TamisiRaduNicolae/audioLF_amp_pcb/pics/crossover_temp2.jpg

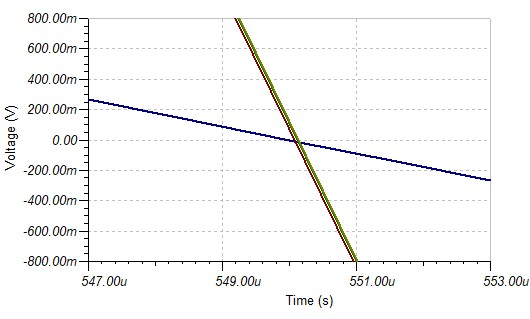
pics/crossover_temp2.jpg
