TamisiRaduNicolae/audioLF_amp_pcb/pics/crossover_temp.jpg

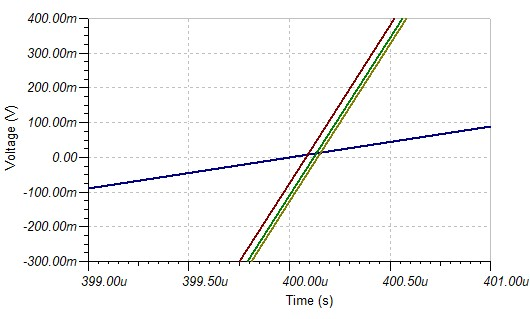
pics/crossover_temp.jpg
