TamisiRaduNicolae/audioLF_amp_pcb/pics/phase_margin.jpg

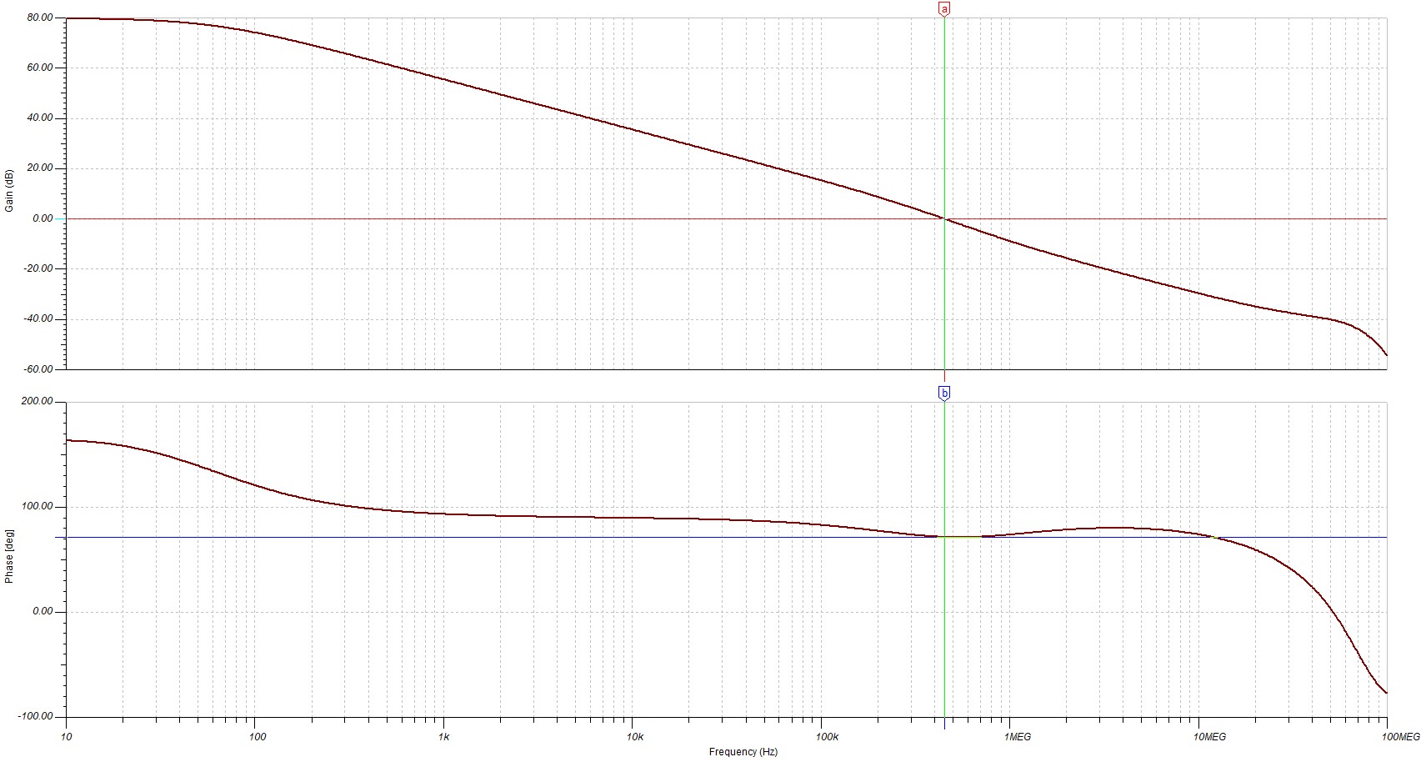
pics/phase_margin.jpg
