TamisiRaduNicolae/audioLF_amp_pcb/pics/rezerva_de_faza_71.66.png

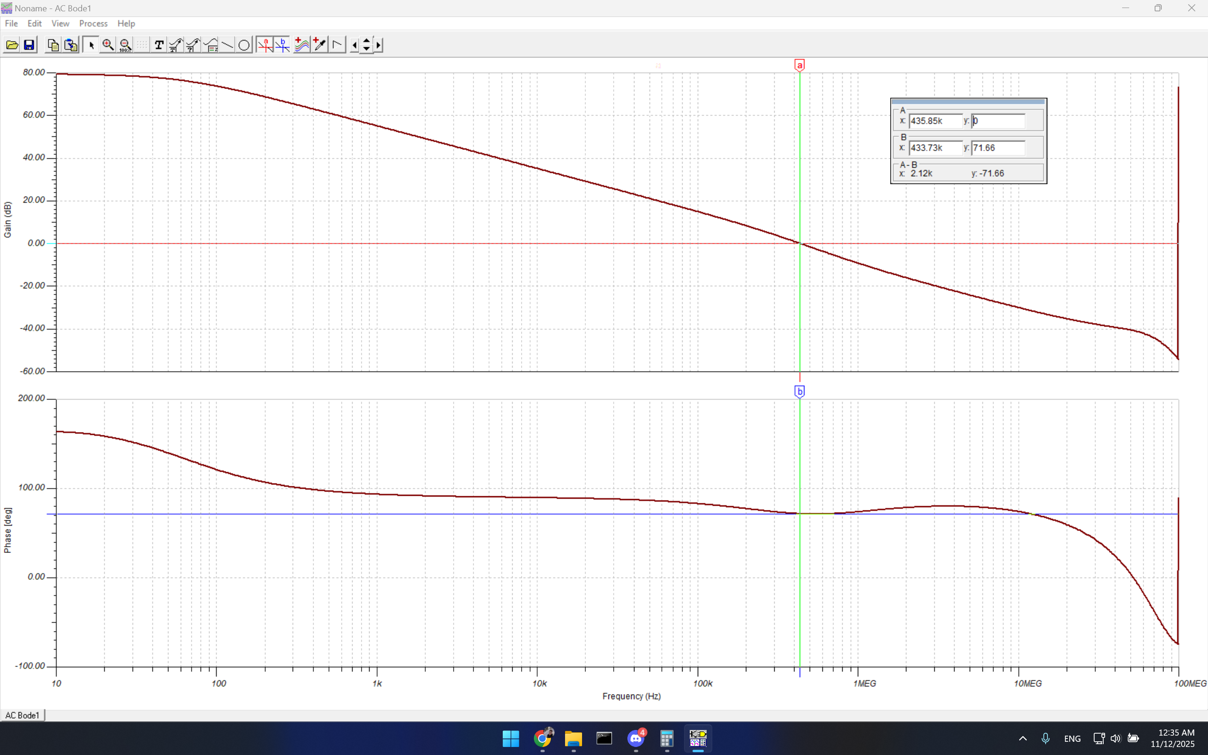
pics/rezerva_de_faza_71.66.png
