TamisiRaduNicolae/audioLF_amp_pcb/pics/Screenshot 2025-10-29 121659.png

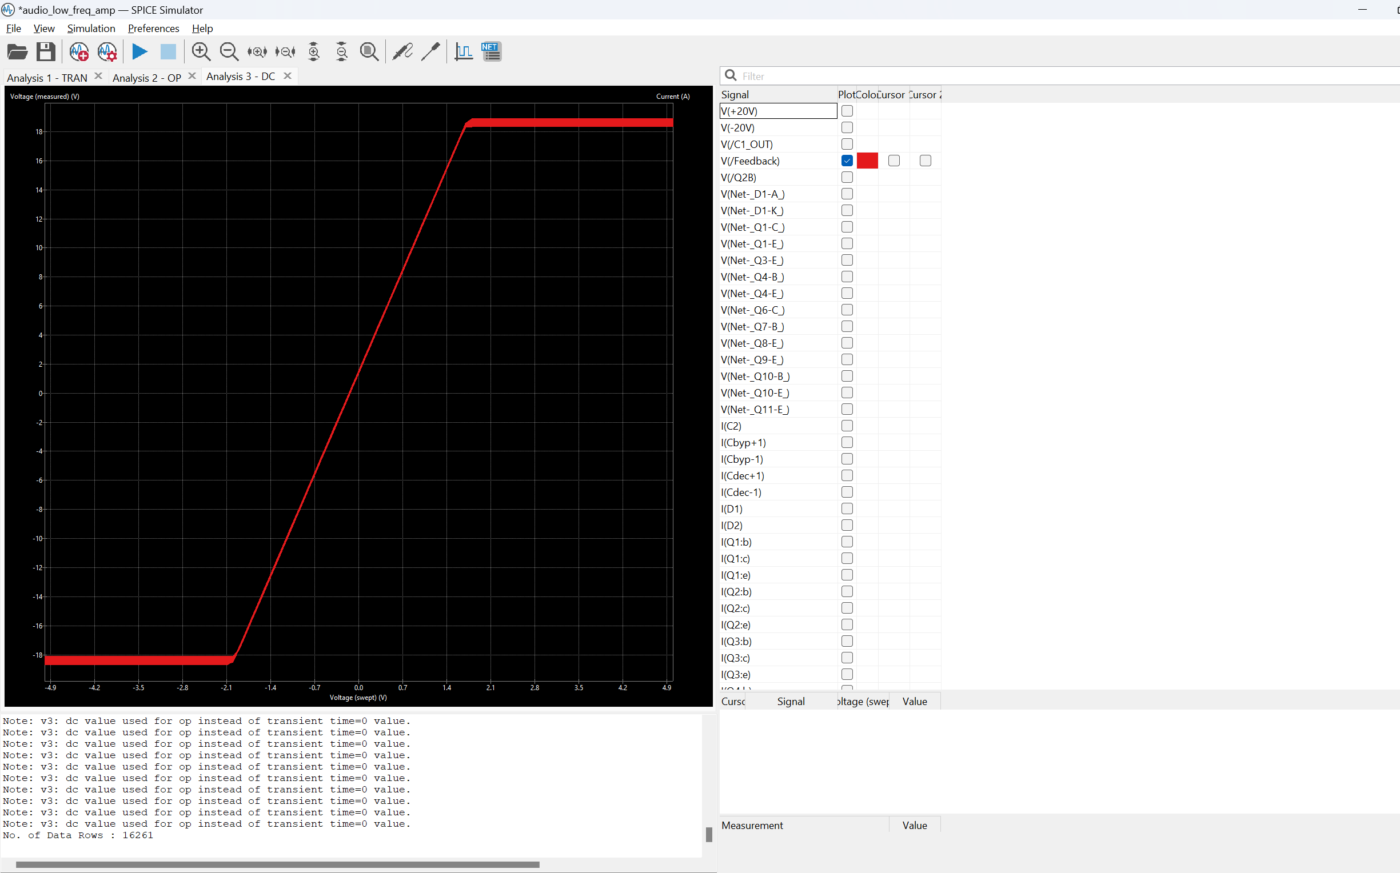
pics/Screenshot 2025-10-29 121659.png
