TamisiRaduNicolae/audioLF_amp_pcb/pics/Screenshot 2025-11-10 224111.png

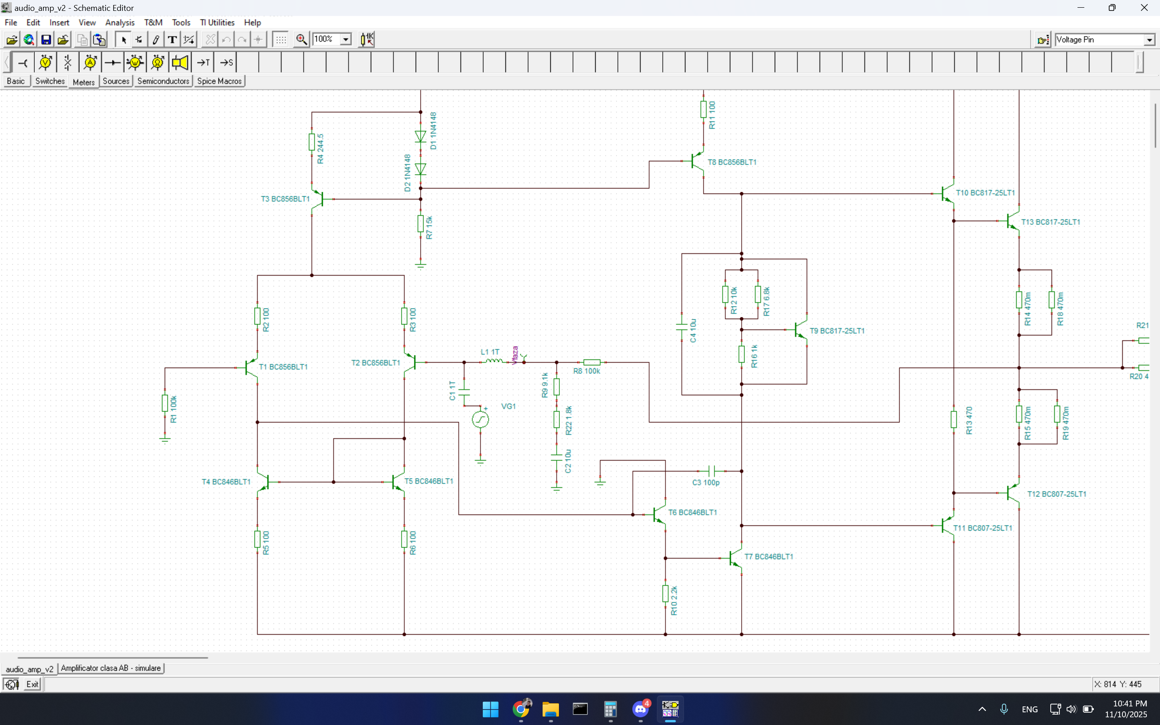
pics/Screenshot 2025-11-10 224111.png
