TamisiRaduNicolae/audioLF_amp_pcb/pics/Screenshot 2025-11-10 224344.png

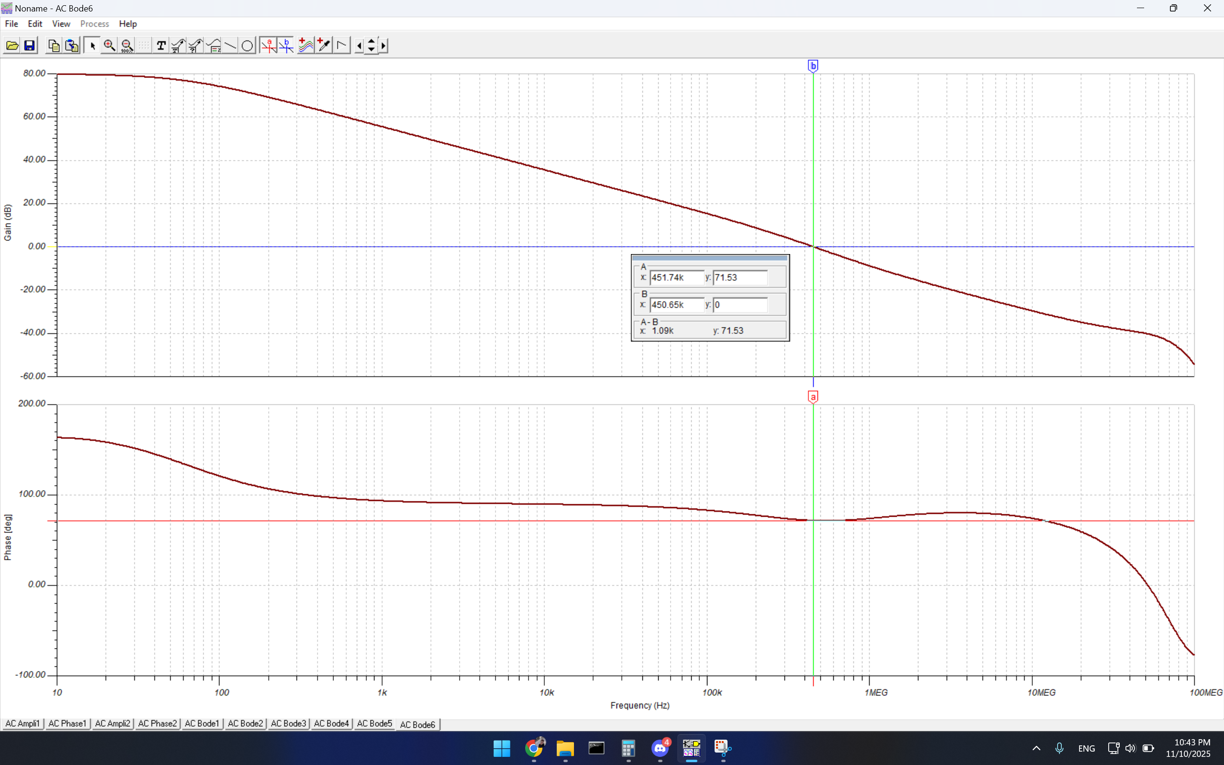
pics/Screenshot 2025-11-10 224344.png
