TamisiRaduNicolae/audioLF_amp_pcb/pics/Screenshot 2025-11-12 001752.png

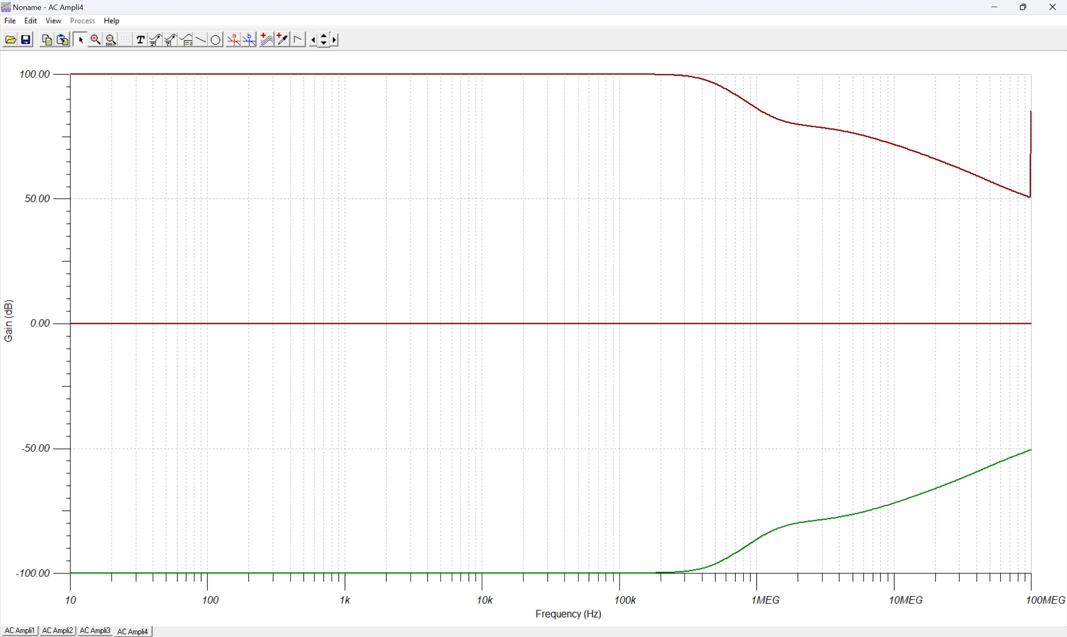
pics/Screenshot 2025-11-12 001752.png
