TamisiRaduNicolae/audioLF_amp_pcb/audio_low_freq_amp/audio_low_freq_amp.kicad_pcb

## KiCad design audio_low_freq_amp/audio_low_freq_amp.kicad_pcb (2025-12-07)

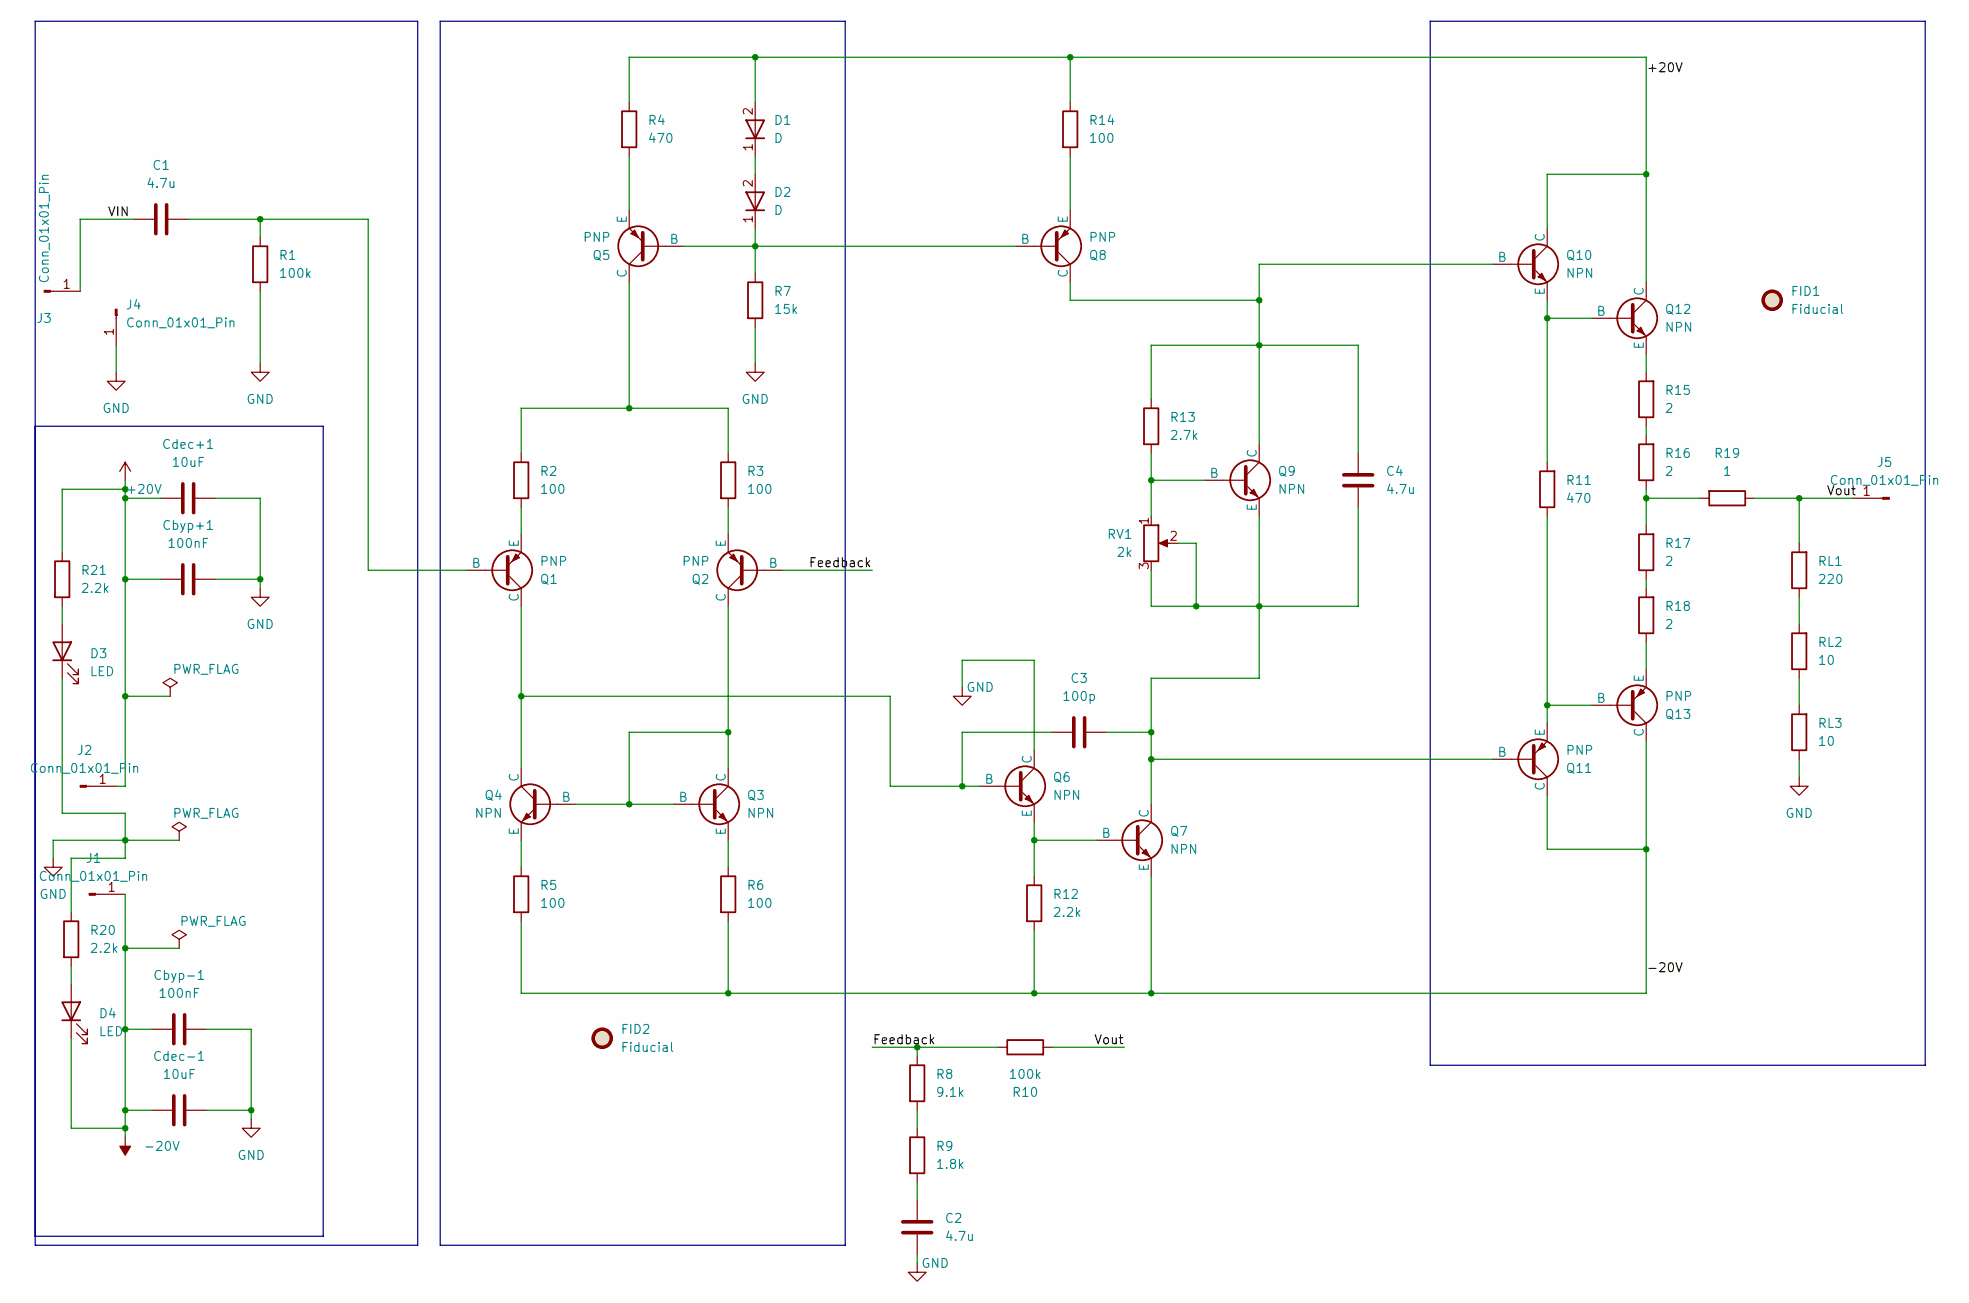
[picture p9: schematic audio_low_freq_amp.kicad_sch]

Parts:
C1, C2, C4: 4.7u; C_0805_2012Metric
C3: 100p; C_0805_2012Metric
Cbyp+1: 100nF; C_0805_2012Metric
Cbyp-1: 100nF; C_0805_2012Metric
Cdec+1: 10uF; 10uF_smd_6.3x5.4_Radu
Cdec-1: 10uF; 10uF_smd_6.3x5.4_Radu
D1, D2: D; D_0805_2012Metric
D3, D4: LED; LED_0805_2012Metric
FID1, FID2: Fiducial; Fiducial_1mm_Mask2mm
J1, J2, J3, J4, J5: Conn_01x01_Pin; J_conn_4x4mm_Radu
Q1, Q2, Q5, Q8, Q11, Q13: PNP; sot23_Radu
Q3, Q4, Q6, Q7, Q9, Q10, Q12: NPN; sot23_Radu
R1, R10: 100k; R_0805_2012Metric
R2, R3, R5, R6, R14: 100; R_0805_2012Metric
R4, R11: 470; R_0805_2012Metric
R7: 15k; R_0805_2012Metric
R8: 9.1k; R_0805_2012Metric
R9: 1.8k; R_0805_2012Metric
R12, R20, R21: 2.2k; R_0805_2012Metric
R13: 2.7k; R_0805_2012Metric
R15, R16, R17, R18: 2; R_0805_2012Metric
R19: 1; R_0805_2012Metric
RL1: 220; R_0805_2012Metric
RL2, RL3: 10; R_0805_2012Metric
RV1: 2k; ts53yl_Radu

Connections:
+20V: Cbyp+1.1, Cdec+1.1, D1.2 (A), J2.1, Q10.1 (C), Q12.1 (C), R4.1, R14.1, R21.1; also elsewhere on the board
-20V: Cbyp-1.1, Cdec-1.2, D4.1 (K), J1.1, Q7.3 (E), Q11.1 (C), Q13.1 (C), R5.2, R6.2, R12.2; also elsewhere on the board
/Feedback: Q2.2 (B), R8.1, R10.1
/VIN: C1.1, J3.1; also elsewhere on the board
/Vout: J5.1, R10.2, R19.1, RL1.2; also elsewhere on the board
GND: C2.1, Cbyp+1.2, Cbyp-1.2, Cdec+1.2, Cdec-1.1, D3.1 (K), J4.1, Q6.1 (C), R1.2, R7.2, R20.1, RL3.1; also elsewhere on the board
unnamed: C2.2, R9.2
unnamed: D1.1 (K), D2.2 (A)
unnamed: D2.1 (K), Q5.2 (B), Q8.2 (B), R7.1
unnamed: D3.2 (A), R21.2
unnamed: D4.2 (A), R20.2
unnamed: C1.2, Q1.2 (B), R1.1
unnamed: C3.1, Q1.1 (C), Q4.1 (C), Q6.2 (B)
unnamed: Q1.3 (E), R2.2
unnamed: Q2.1 (C), Q3.1 (C), Q3.2 (B), Q4.2 (B)
unnamed: Q2.3 (E), R3.2
unnamed: Q3.3 (E), R6.1
unnamed: Q4.3 (E), R5.1
unnamed: Q5.1 (C), R2.1, R3.1
unnamed: Q5.3 (E), R4.2
unnamed: Q6.3 (E), Q7.2 (B), R12.1
unnamed: Q8.3 (E), R14.2
unnamed: Q9.2 (B), R13.2, RV1.1
unnamed: C4.2, Q8.1 (C), Q9.1 (C), Q10.2 (B), R13.1
unnamed: Q10.3 (E), Q12.2 (B), R11.2
unnamed: C3.2, C4.1, Q7.1 (C), Q9.3 (E), Q11.2 (B), RV1.2, RV1.3
unnamed: Q11.3 (E), Q13.2 (B), R11.1
unnamed: Q12.3 (E), R15.2
unnamed: Q13.3 (E), R18.1
unnamed: R8.2, R9.1
unnamed: R15.1, R16.2
unnamed: R16.1, R17.2, R19.2
unnamed: R17.1, R18.2
unnamed: RL1.1, RL2.2
unnamed: RL2.1, RL3.2

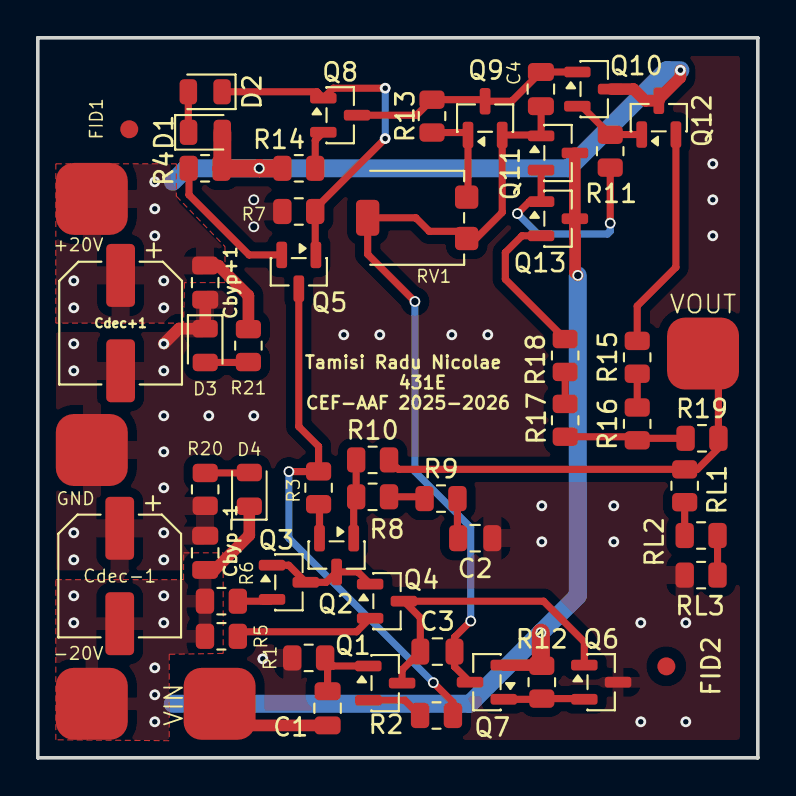
[picture p10: board audio_low_freq_amp.kicad_pcb from above]

Board: 2 copper layers, 40.0 x 40.0 mm, 57 parts (0 on the bottom side), 35 nets.

Other parts of the board:
+20V: Conn_01x01_Pin; J_conn_4x4mm_Radu
-20V: Conn_01x01_Pin; J_conn_4x4mm_Radu
GND: Conn_01x01_Pin; J_conn_4x4mm_Radu
VIN: Conn_01x01_Pin; J_conn_4x4mm_Radu
VOUT: Conn_01x01_Pin; J_conn_4x4mm_Radu

Their connections:
+20V: +20V.1; also elsewhere on the board
-20V: -20V.1; also elsewhere on the board
/VIN: VIN.1; also elsewhere on the board
/Vout: VOUT.1; also elsewhere on the board
GND: GND.1; also elsewhere on the board
