TamisiRaduNicolae/audioLF_amp_pcb/(commit log)

2025-10-20 created the schematicin kicad 9 and placed power and signal sources
    [audio_low_freq_amp.kicad_pcb, audio_low_freq_amp.kicad_sch]
2025-10-22 finished unrefined version of the schematic with a new approach in mind. works very good for beginning, but needs more work. great place to start bc we almost got a sine wave at output and gain is a 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
    [audio_low_freq_amp.kicad_sch]
2025-10-29 commit before going to check up with the professor
    [audio_low_freq_amp.kicad_sch]
2025-11-23 modified final sch in tina and kicad
    [audio_low_freq_amp.kicad_sch]
2025-11-29 added constraints to pcb and did some custom footprints
    [audio_low_freq_amp.kicad_pcb, audio_low_freq_amp.kicad_sch]
2025-11-30 layed out the parts on pcb, next is routing
    [audio_low_freq_amp.kicad_pcb, audio_low_freq_amp.kicad_sch]
2025-11-30 made some placing adjustments. should be ready for first routing stage
    [audio_low_freq_amp.kicad_pcb]
2025-11-30 finished first iteration of routing
    [audio_low_freq_amp.kicad_pcb]
2025-12-07 moved fiducial fid2 to be diagonally oposed with the first and made adjustments to traces and pours
    [audio_low_freq_amp.kicad_pcb]
2025-12-07 found some unconnected traces and resolved; still have some insignificant errors (2) about not having minimum 2 spokes for thermal relief
    [audio_low_freq_amp.kicad_pcb]
